nlvkhang2105/Summer-Projects/Control Unit/Control Unit.kicad_pcb

## KiCad design Control Unit/Control Unit.kicad_pcb (2026-07-01)

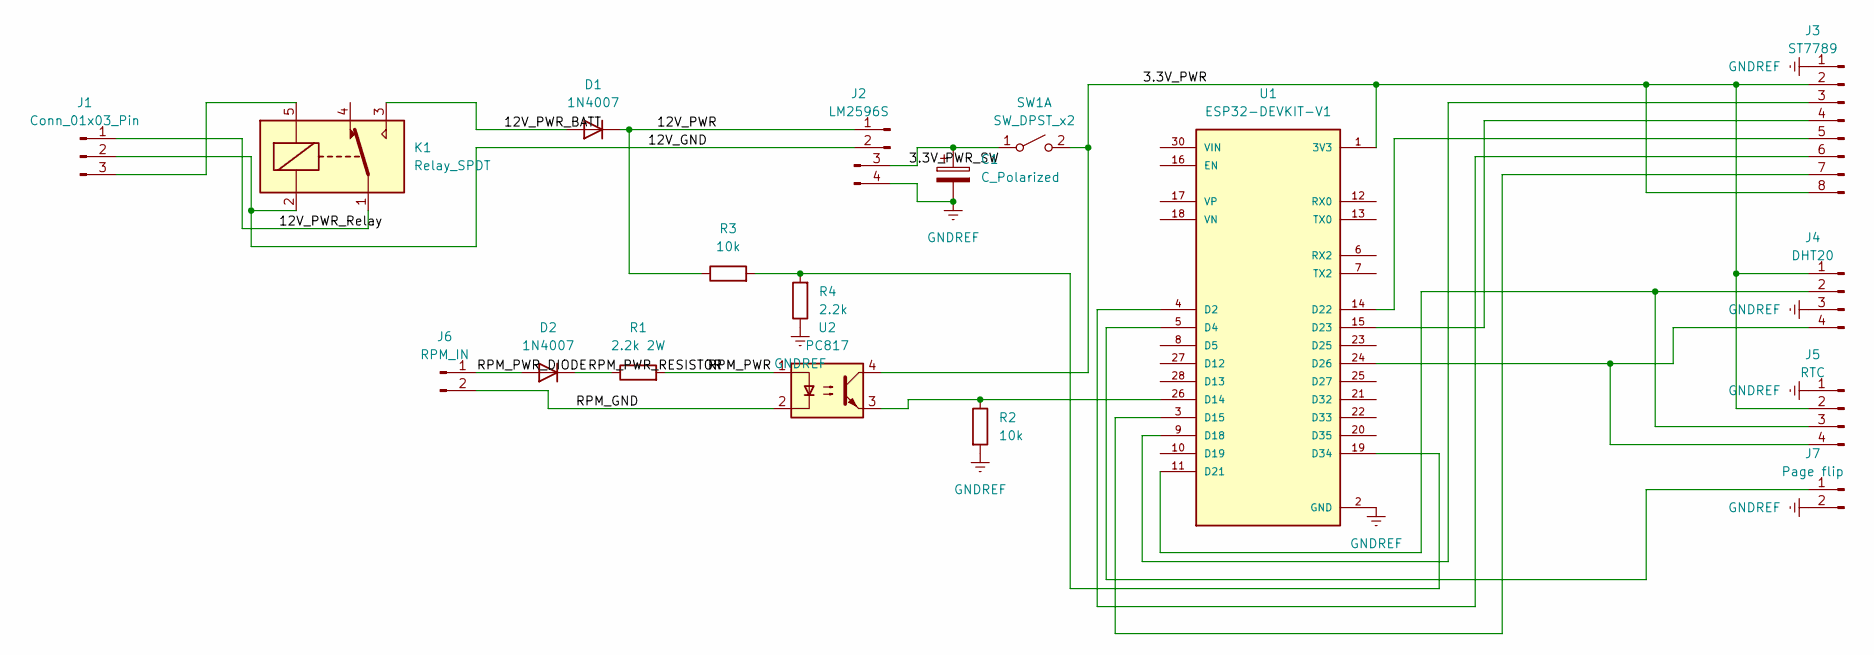
[picture p1: schematic Control Unit.kicad_sch]

Parts:
C1: C_Polarized; CP_Radial_D12.5mm_P5.00mm
D1, D2: 1N4007; D_DO-41_SOD81_P10.16mm_Horizontal
J1: Conn_01x03_Pin; SolderWire-1.5sqmm_1x03_P6mm_D1.7mm_OD3mm
J2: LM2596S; LM2596S-footprint-Custom
J3: ST7789; JST_XA_B08B-XASK-1_1x08_P2.50mm_Vertical
J4: DHT20; JST_XA_B04B-XASK-1_1x04_P2.50mm_Vertical
J5: RTC; PinHeader_1x06_P2.54mm_Vertical
J6: RPM_IN; JST_XA_B02B-XASK-1_1x02_P2.50mm_Vertical
J7: Page flip; JST_XA_B02B-XASK-1_1x02_P2.50mm_Vertical
K1: Relay_SPDT; Relay_SPDT_SANYOU_SRD_Series_Form_C
R1: 2.2k 2W; R_Axial_DIN0516_L15.5mm_D5.0mm_P20.32mm_Horizontal
R2, R3: 10k; R_Axial_DIN0207_L6.3mm_D2.5mm_P7.62mm_Horizontal
R4: 2.2k; R_Axial_DIN0207_L6.3mm_D2.5mm_P7.62mm_Horizontal
SW1: SW_DPST_x2; SW_SPDT_CK_JS102011SAQN
U1: ESP32-DEVKIT-V1; MODULE_ESP32_DEVKIT_V1; PARTREV N/A
U2: PC817; DIP-4_W7.62mm

Connections:
/3.3V_PWR: J3.2 (Vcc), J3.8, J4.1 (Vcc), J5.2 (Vcc), SW1.2 (B), U1.1 (3V3), U2.4
/3.3V_PWR_SW: C1.1, J2.3 (3.3V_out), SW1.1 (A)
/12V_GND: J1.2 (GND), J2.2 (12V_GND), K1.2
/12V_PWR: D1.1 (K), J2.1 (12V_in), R3.1
/12V_PWR_BATT: D1.2 (A), K1.3
/12V_PWR_Relay: J1.1 (12V_PWR), K1.1
/RPM_GND: J6.2, U2.2
/RPM_PWR: R1.2, U2.1
/RPM_PWR_DIODE: D2.2 (A), J6.1 (RPM_IN)
/RPM_PWR_RESISTOR: D2.1 (K), R1.1
GNDREF: C1.2, J2.4 (3.3V_GND), J3.1 (GND), J4.3 (GND), J5.1 (GND), J7.2, R2.2, R4.1, U1.2 (GND), U1.29 (GND)
unnamed: J1.3 (12V_SWITCH), K1.5
unnamed: J3.7 (CS), U1.3 (D15)
unnamed: J3.6 (DC), U1.4 (D2)
unnamed: J3.5 (RES), U1.14 (D22)
unnamed: J3.3 (SCL), U1.9 (D18)
unnamed: J3.4 (SDA), U1.15 (D23)
unnamed: J4.4 (SCL), J5.4 (SCL), U1.24 (D26)
unnamed: J4.2 (SDA), J5.3 (SDA), U1.11 (D21)
unnamed: J7.1 (SIG), U1.5 (D4)
unnamed: R2.1, U1.26 (D14), U2.3
unnamed: R3.2, R4.2, U1.19 (D34)

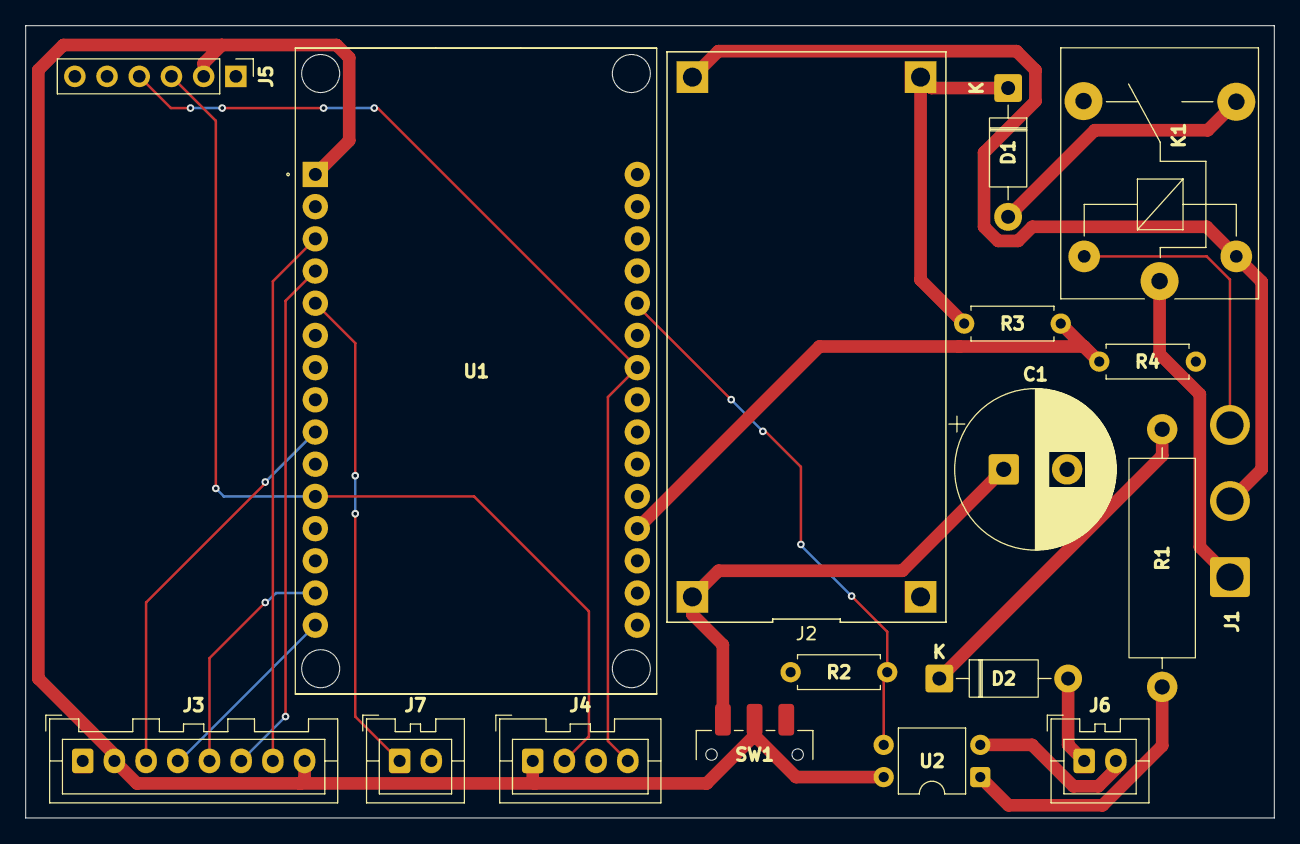
[picture p2: board Control Unit.kicad_pcb from above]

Board: 2 copper layers, 98.5 x 62.5 mm, 18 parts (0 on the bottom side), 22 nets.
