nlvkhang2105/Summer-Projects/(commit log)

2026-06-26 beta 1.0
    [Control Unit.kicad_pcb, Control Unit.kicad_sch]
2026-06-27 rev 1.0
    [Control Unit-B_Cu.gbr, Control Unit-B_Mask.gbr, Control Unit-B_Paste.gbr, Control Unit-B_Silkscreen.gbr, Control Unit-Edge_Cuts.gbr, Control Unit-F_Cu.gbr, Control Unit-F_Mask.gbr, Control Unit-F_Paste.gbr]
2026-06-29 rev 1.1: added relay to use power directly from battery
    [Control Unit-B_Cu.gbr, Control Unit-B_Mask.gbr, Control Unit-B_Paste.gbr, Control Unit-B_Silkscreen.gbr, Control Unit-Edge_Cuts.gbr, Control Unit-F_Cu.gbr, Control Unit-F_Mask.gbr, Control Unit-F_Paste.gbr]
2026-06-29 rev 1.1b: optimized PCB size
    [Control Unit-B_Cu.gbr, Control Unit-B_Mask.gbr, Control Unit-B_Paste.gbr, Control Unit-B_Silkscreen.gbr, Control Unit-Edge_Cuts.gbr, Control Unit-F_Cu.gbr, Control Unit-F_Mask.gbr, Control Unit-F_Paste.gbr]
2026-07-01 rev1.1: polished user interface
    [Control Unit-B_Cu.gbr, Control Unit-B_Mask.gbr, Control Unit-B_Paste.gbr, Control Unit-B_Silkscreen.gbr, Control Unit-Edge_Cuts.gbr, Control Unit-F_Cu.gbr, Control Unit-F_Mask.gbr, Control Unit-F_Paste.gbr]
